yuxuan-518/automatic-cat-feeder/docs/food-preservation.md

# Food Preservation Study

**[Project Overview](../README.md) · [Mechanical Design](mechanical-design.md) · [Motor & Automation](motor-and-automation.md) · [Food Preservation](food-preservation.md)**

This page is reserved for [Wenhao Jia](https://github.com/jw3422951-ops) to document the chemistry and food-preservation portion of the project through his Fork and a Pull Request.

To preserve accurate authorship, the main repository does not infer his experimental question, materials, procedure, measurements, results, or conclusions. The completed contribution can replace this page while retaining the navigation links above.

Suggested sections for the contributor-authored page:

- Research question and preservation goal
- Materials or moisture-control methods considered
- Experimental procedure and controls
- Recorded measurements and observations
- Results, limitations, and selected approach
- Contributor statement
