yuxuan-518/automatic-cat-feeder/docs/source/export-notes.md

# 自动喂猫器项目导出说明

来源：https://github.com/147y111/Automatic-Cat-Feeder
分支：main
版本：46711cf435dc37880b16b992918d4c8a72f1e8ab
导出时间（UTC）：2026-11-09T08:08:31+00:00

## 分类统计

- 图片：0 个原仓库文件
- 视频：2 个原仓库文件
- CAD：1 个原仓库文件
- 代码：35 个原仓库文件
- 文档：4 个原仓库文件

共导出 42 个原仓库文件，每个文件均已按 Git 文件哈希核对，并在分类复制后再次校验 SHA256。未改动代码、CAD、视频和原始文档的内容。

## 文件导航

- [完整 STEP 装配模型](CAD/automatic_cat_feeder_assembly.step)
- [整机演示视频](视频/automatic_cat_feeder_demo.mp4)
- [高扭矩电机测试视频](视频/high_torque_motor_test.mp4)
- [高扭矩电机代码及说明](代码/high_torque_motor/README.md)
- [NEMA17 电机代码使用说明](代码/nema17_motor/使用说明.txt)
- [原仓库总说明](文档/README.md)
- [机械设计说明](文档/docs/mechanical-design.md)
- [电机与自动化说明](文档/docs/motor-and-automation.md)
- [食物保存说明](文档/docs/food-preservation.md)
- [全部文件清单及校验值](文件清单.csv)

## 保存说明

- 当前 main 分支没有独立图片文件，因此“图片”文件夹为空；未从视频中另行截取图片。
- “代码”完整保留两套项目的内部目录、配置、说明和隐藏的 .gitignore 文件。
- 原始文档内容保持不变，其中部分相对链接仍对应原仓库结构；请通过上方导航或 GitHub 查看关联内容。
- 原 README 中嵌入的两个 user-attachments 视频链接在导出时均返回 HTTP 404，无法另行下载；仓库 media 目录中的两个 MP4 文件已完整导出。
- 本次保存当前版本的全部已跟踪文件，不包含 .git 提交历史，也没有编译或运行下载的代码。

说明页中的视频外链：

- https://github.com/user-attachments/assets/3802f599-0b08-426b-a826-65936d58fb92
- https://github.com/user-attachments/assets/d001d56f-1696-4ed1-9d0b-61fb5bd48209
