yuxuan-518/automatic-cat-feeder/assets/images/physical-feeder-preview.jpg

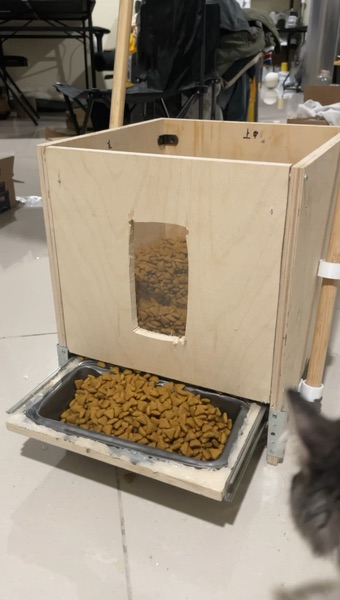
assets/images/physical-feeder-preview.jpg
