yuxuan-518/automatic-cat-feeder/docs/source/materials-index.md

# Automatic Cat Feeder — Materials Index

This folder contains the organized source materials for the Automatic Cat Feeder project.

## Folder Structure

- `Videos/Completed_Feeder_Prototype.mp4` — completed feeder prototype demonstration
- `Videos/Higher_Torque_Motor_Test.mp4` — higher-torque motor rotation test
- `Videos/Additional_Project_Video_To_Confirm.mp4` — additional original project video awaiting content confirmation
- `CAD/automatic_cat_feeder_assembly.step` — complete 40-instance CAD assembly
- `Code/nema17_motor/` — original NEMA17 controller source and notes
- `Code/high_torque_motor/` — higher-torque motor controller source, tests, and notes
- `Documentation/README.md` — GitHub project overview
- `Documentation/mechanical-design.md` — mechanical design and fabrication details
- `Documentation/motor-and-automation.md` — motor and automation details
- `Documentation/food-preservation.md` — food-preservation contributor page

The files in this desktop collection are copies. Their original GitHub repository and WeChat video files were not moved or deleted.
