yuxuan-518/automatic-cat-feeder/cad/automatic_cat_feeder_assembly.step

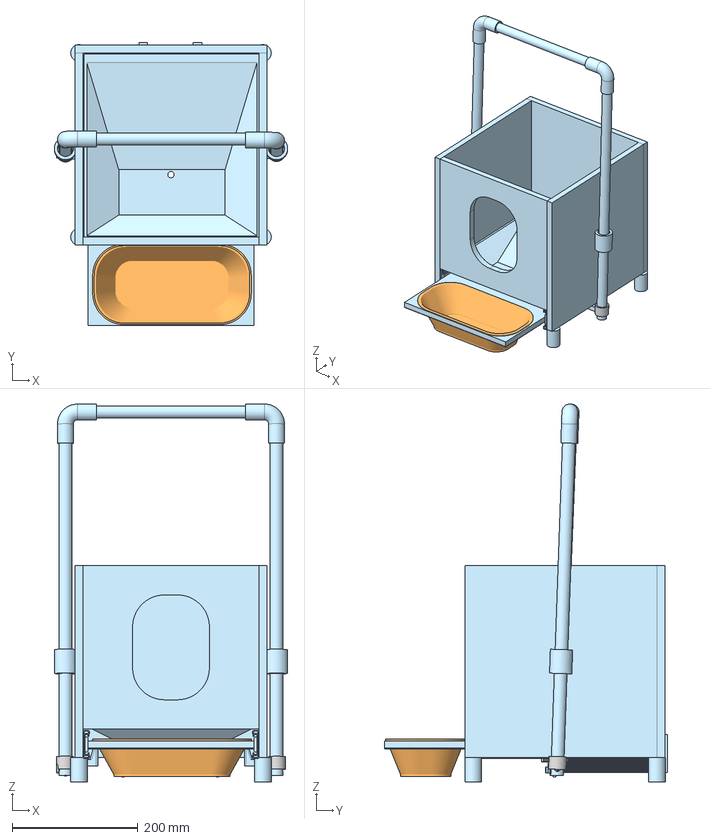
[picture p4: CAD file, 2026-11-10]
cad/automatic_cat_feeder_assembly.step
370.8 x 450.2 x 600.5 mm
NEMA17 Stepper 42x20.5:1__Shaft x 2
Spur gear (18 teeth) x 2
