yuxuan-518/automatic-cat-feeder/(commit log)

2026-11-10 Publish automatic cat feeder project materials
    [automatic_cat_feeder_assembly.step, file-manifest.csv]
2026-11-11 Remove CAD motion video from README
